HclX/DELL_POWER_SPOOFER/PCB/schematic.pdf

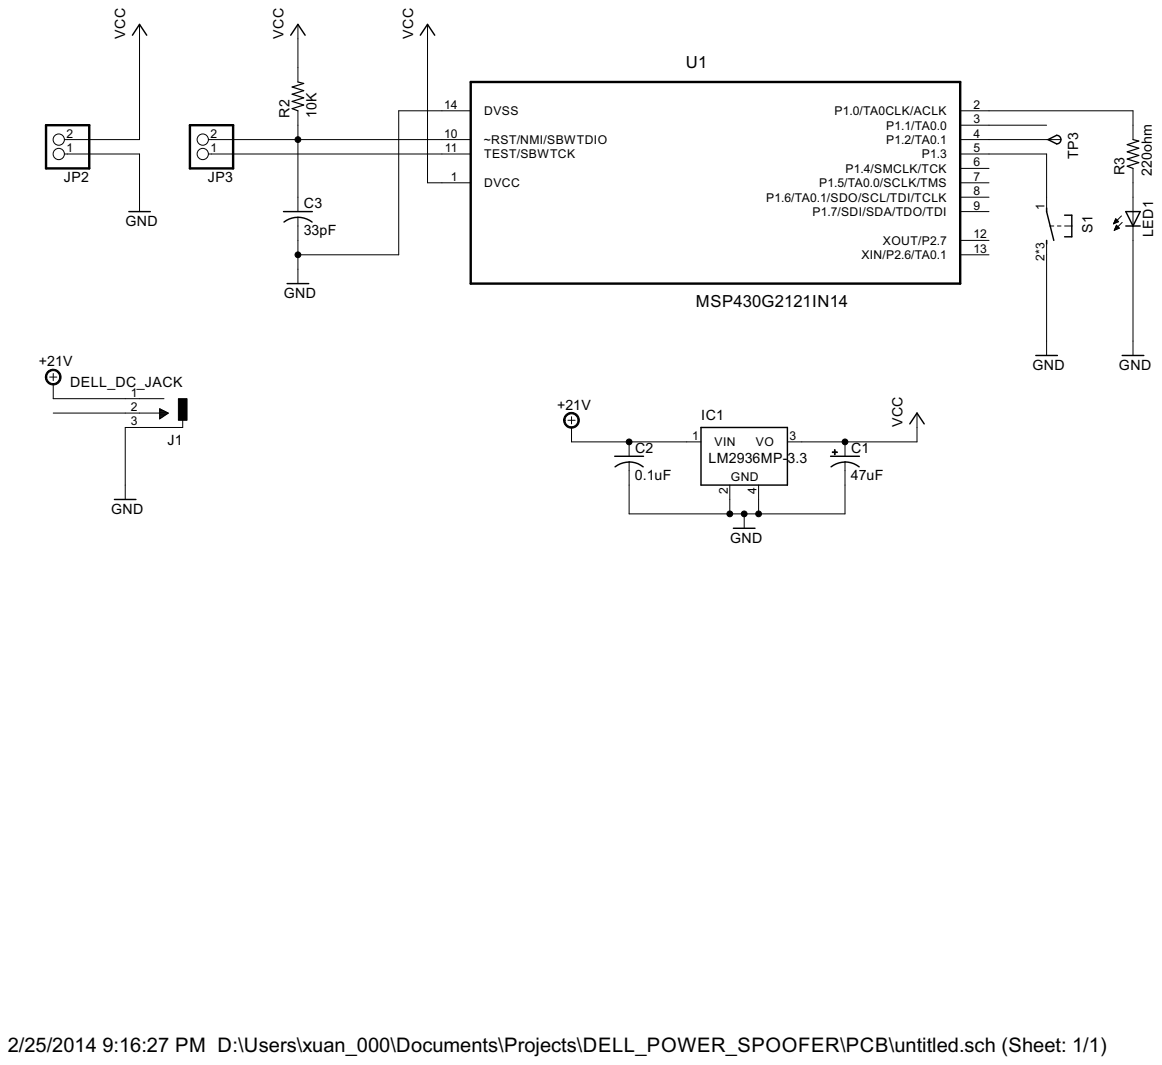
[picture p1: page 1]

7 P1.6/TA0.1/SDO/SCL/TDI/TCLK

2/25/2014 9:16:27 PM D:\Users\xuan_000\Documents\Projects\DELL_POWER_SPOOFER\PCB\untitled.sch (Sheet: 1/1)
