HclX/DELL_POWER_SPOOFER/PCB/layout.pdf

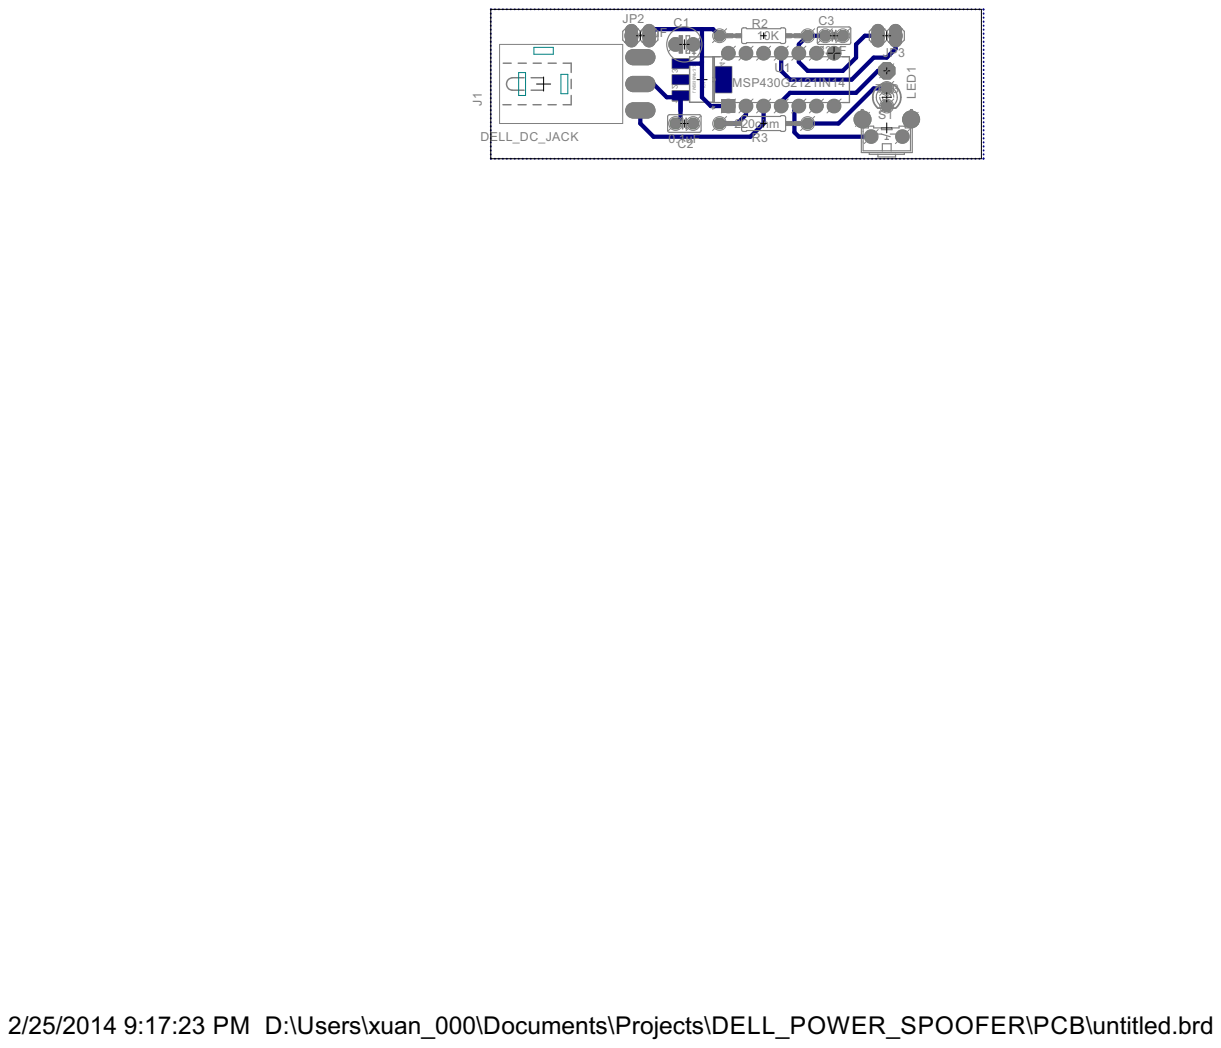
[picture p2: page 1]

2/25/2014 9:17:23 PM D:\Users\xuan_000\Documents\Projects\DELL_POWER_SPOOFER\PCB\untitled.brd
