HclX/DELL_POWER_SPOOFER/PCB/untitled.brd

## EAGLE design PCB/untitled.brd (2014-02-26)

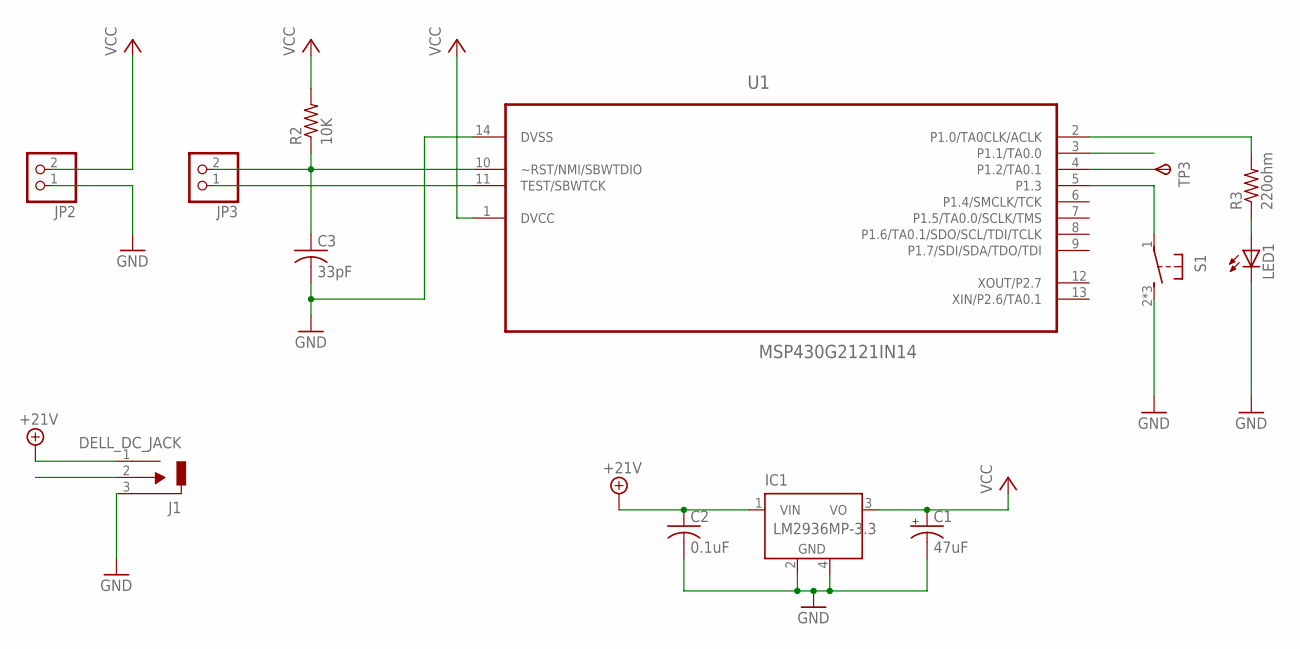
[picture p3: schematic untitled.sch]

Parts:
C1: 47uF; E2,5-5
C2: 0.1uF; C025-025X050
C3: 33pF; C025-025X050
IC1: LM2936MP-3.3; SOT223
J1: DELL_DC_JACK
JP2, JP3: PINHD-1X2; 1X02
LED1: LED3MM
R2: 10K; 0207/12
R3: 220ohm; 0207/12
S1: 31-XX; B3F-31XX
TP3: TPSPAD1-13; P1-13
U1: MSP430G2121IN14; DIP254P762X508-14

Connections:
+21V: C2.1, IC1.1 (VIN), J1.1 (VIN)
GND: C1.-, C2.2, C3.2, IC1.2 (GND), IC1.4 (GND), J1.3 (GND), JP2.1, LED1.K (C), S1.2 (S), S1.3 (S), S1.4 (S), U1.14 (DVSS)
unnamed: C3.1, JP3.2, R2.1, U1.10 (~RST/NMI/SBWTDIO)
unnamed: JP3.1, U1.11 (TEST/SBWTCK)
unnamed: R3.2, U1.2 (P1.0/TA0CLK/ACLK)
unnamed: LED1.A, R3.1
unnamed: TP3.TP, U1.4 (P1.2/TA0.1)
unnamed: S1.1, U1.5 (P1.3)
SIG: J1.2 (SIG), U1.3 (P1.1/TA0.0)
VCC: C1.+, IC1.3 (VO), JP2.2, R2.2, U1.1 (DVCC)

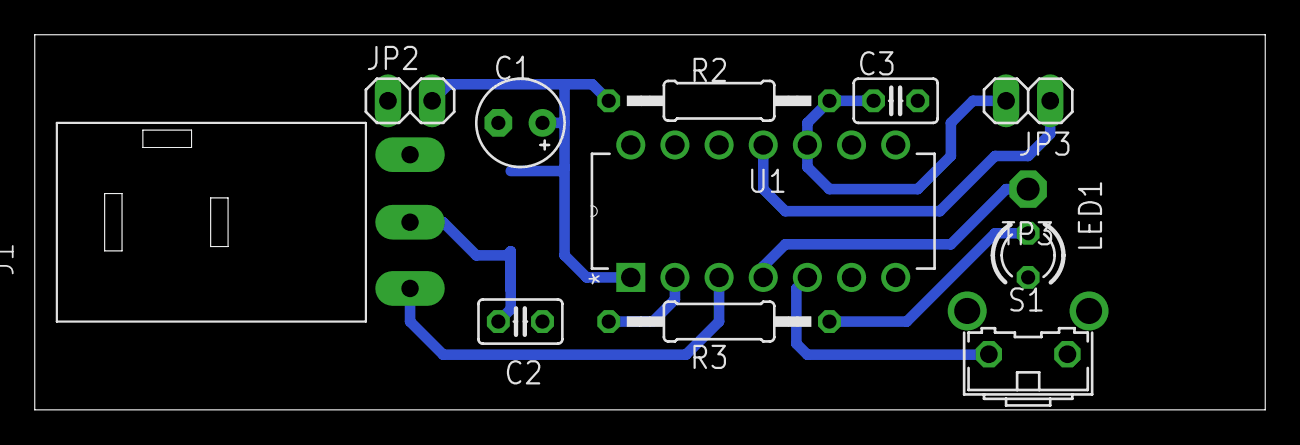
[picture p4: board untitled.brd from above]

Board: 2 copper layers, 70.8 x 21.6 mm, 13 parts (1 on the bottom side), 10 nets.
