HclX/DELL_POWER_SPOOFER/(threads)

Thread 1 (2016-06-30):

2 suggestions for hardware robustness

evanshultz, 2016-06-30:
Great work! Thanks for sharing.

There are two hardware suggestions I have which aren't too important for a hobby project but are good practice. They cover unlikely scenarios, but are worthwhile for robustness.

First, I suggest adding a reverse diode across the regulator, with the anode at the regulator output. If the input voltage drops below the output voltage, which can sometimes happen during power off, the pass transistor in the regulator can become damaged by reverse current. This is probably unlikely since the power supply output likely has a very long holdup, but it won't hurt and there could be conditions that would cause the regulator input voltage to fall first. A standard 4148 will suffice.

Second, depending on what receives the signal in the laptop, it may also be prudent to put Schottky diodes from ground to the uC signal output and from the uC output to +3.3V. A series resistor between the uC and diodes is also good protection. The receiving circuitry could pull the pin below ground or above +3.3V in an unexpected condition, generally a serious fault, which would likely damage the uC.

Thread 2 (2018-05-20):

Embedded Controller question

UDPSendToFailed, 2018-05-20:
Hi! Seen your blog, nice work. I can't really do that hardware mod, but i have an idea: manually entering the required values to laptop's embedded controller. Tested out with RW-Everything, when i plug in a broken adapter, and it's charging for 2-3 seconds, then disables, the following happens:

- Byte 0x07 changes to 20 while charging, then E0 when it disables
- Byte 0x3B changes to 30, then 31

Tried to enter that values, but instantly reverts back to disabled. Editing byte 0x06 sometimes brings up the QuickSet app's unknown adapter warning, for example at values 01, 03, 09, etc.

Also there is an empty space, maybe the laptop would store here the data received from charger?

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

Seen your code...

"Memory dump:

String format: DELL00AC090195046CN09T2157161543835EAL03

Hex format:

44 45 4C 4C 30 30 41 43 30 39 30 31 39 35 30 34 36 43 4E 30 39 54 32 31 35 37 31 36 31 35 34 33 38 33 35 45  41 4C 30 33 E0 A9 FF FF FF FF FF FF FF FF FF FF FF FF FF FF FF FF FF FF FF FF FF FF FF FF FF FF FF FF FF FF  FF FF FF FF FF FF FF FF FF FF FF FF FF FF FF FF FF FF FF FF FF FF FF FF FF FF FF FF FF FF FF FF FF FF FF FF
FF FF FF FF FF FF FF FF FF FF FF FF FF FF FF FF FF FF FF FF"

Maybe entering this to empty space should force the laptop to charge, but i don't know, where to start it in bytes? Thanks for reply! :)

alxpettit, 2019-04-03:
Any progress on this?

UDPSendToFailed, 2019-04-06:
I gave up the EC modding, it looks impossible to do. Instead of software trick, I have disassembled the AC adapter, removed the TO-92 package identification chip, and soldered it directly in the laptop to the DC jack. Now the laptop detects every AC adapter as original Dell and charges the battery without problems. If you don't want to mess with disassembling the charger, you can disable the CPU speed limit using ThrottleStop: https://youtu.be/2Cvb30puRwU

alxpettit, 2019-04-06:
Oh! i thought about doing that, yeah :)

alxpettit, 2019-04-06:
And yeah I don't mind disassembling a charger. I have a bunch of old dell chargers, actually. Thanks for reporting it as working! It's good to know.

alxpettit, 2019-04-06:
My only concern is, what if the charger you pulled the chip from was lower wattage than the charger you plug in? Would that cause the power supply voltage to drop because it pulls too much current? Some (bad) charging circuitry can be damaged by that sort of thing.

UDPSendToFailed, 2019-04-07:
I think it will be fine. Generally it's safe to use adapters with the same voltage, and same or higher amperage/wattage. For example if you use chip from a 65W charger, and you connect a 90W charger, the laptop will adapt to 65W available power. If you use 65W chip and 45W adapter, then yes, it can cause problems, because the laptop thinks the available power is 65W, so it may overload or damage the 45W adapter, same with 90W chip and 65W adapter, etc. The best way to solve this is checking the laptop's power requirements, and use a chip matching it with an adapter which has matching/higher wattage. I don't know what happens if there are two chips connected, one soldered and one in a working adapter, I have desoldered the identification wire from the DC jack.

mozboz, 2019-04-29:
> I gave up the EC modding, it looks impossible to do. Sadly the EC firmware is not open-source, Coreboot doesn't support Dell laptops, and I have no enough BIOS modding skills to remove the check. Instead of software trick, I have disassembled the AC adapter, removed the TO-92 package identification chip, and soldered it directly in the laptop to the DC jack. Now the laptop detects every AC adapter as original Dell and charges the battery without problems. If you don't want to mess with disassembling the charger, you can disable the CPU speed limit using ThrottleStop: https://youtu.be/2Cvb30puRwU

Sorry for OT post, but for anyone else on the horrendous interwebs search for ThrottleStop for Linux, the answer is here: https://askubuntu.com/questions/337147/throttlestop-for-ubuntu
