HclX/DELL_POWER_SPOOFER/(commit log)

2014-02-26 Separating from original repository
    [untitled.brd, untitled.sch]
2014-02-26 printing out layout and schematic pdf files
    [untitled.brd, untitled.sch]
